Astrosloth-microcontrollers/Astrosloth-ReflowOvenController/SchematicPDF.pdf

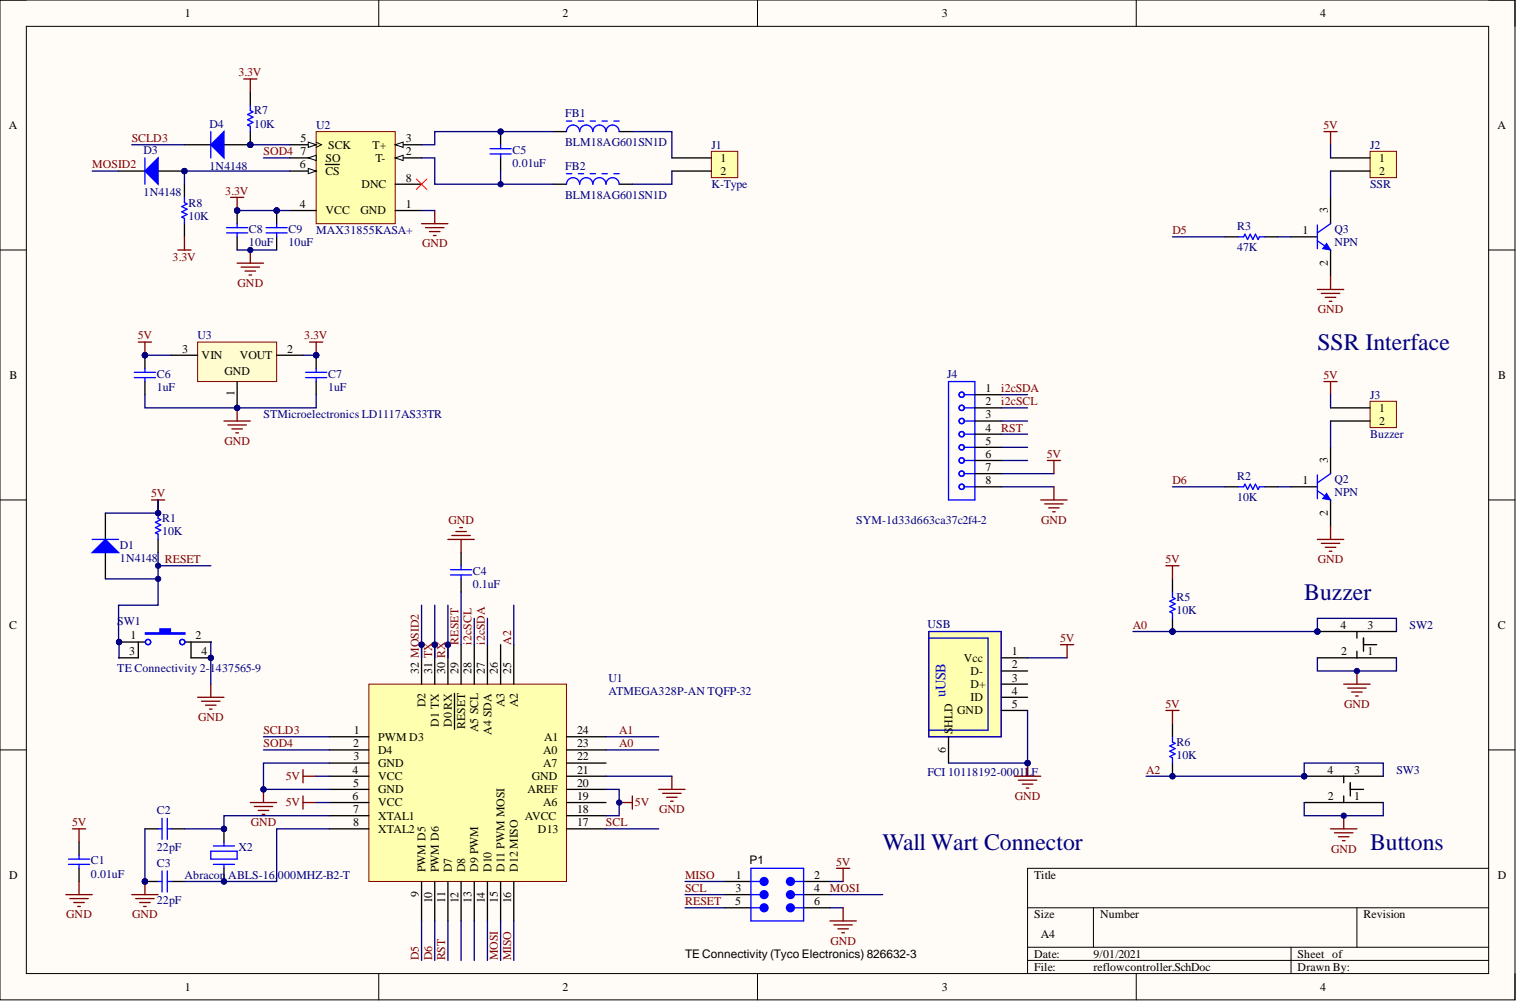
[picture p1: page 1]

SCK T-D N C VCC G N D | 1 S N 1 D
